MaximeM48/Projet-Arduino-/Documentation/Inspirations/Design global.jpg

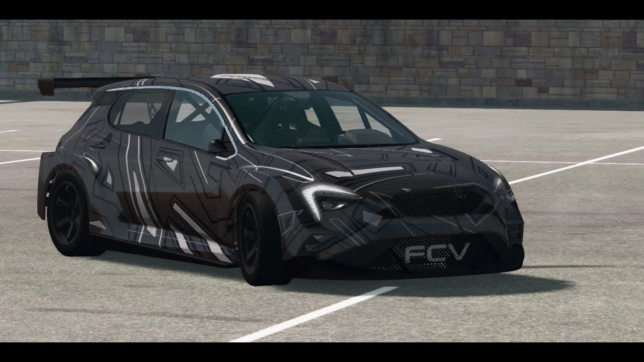
Documentation/Inspirations/Design global.jpg
