MaximeM48/Projet-Arduino-/README.md

# Projet Vivace
Voiture radiocommandée Arduino
# Présentation (Cahier des charges)
L'objectif du projet Vivace est de passer du jeu vidéo à la réalité en créant une voiture radiocommandée contrôlable à longue distance (par une manette de jeu) et dotée d'une caméra avant et arrière (et d'un radar de recul) afin d'avoir un retour vidéo.
De plus, la voiture sera dotée de quatres roues motrices, de suspensions réglables afin de modifier la garde au sol du véhicule et d'éléments esthétiques déplyables comme un aileron arrière, avant et des phares de rallye sur le capot. La voiture aura donc des modes de conduite pré-enregistés (route, circuit, rallye) qui pourront être séléctionnés par l'utilisateur ainsi que tous les feux fonctionnels.
L'objectif final de ce projet serait de développer une application ou une interface permettant d'avoir accès à toutes les informations de la voiture: feux activés, éléments esthétiques déployés, vitesse, retour caméra, mode de conduite sélectionné. De plus, touts ces éléments pourraient être actionés de manière indépendente par l'utilisateur, ce qui lui permettrait de créer ses propres "preset", qui seraient ensuite sauvegardés.
