MaximeM48/Projet-Arduino-/Rapports séances/KiliannCAVANIE/rapport 7.odt

Aujourd’hui on essaye de faire rouler la voiture. On assemble donc les éléments :

-récupération d’une plus petite plaque de connexion pour plus de place sur la voiture

-soudure des câbles au moteur et soudure de connecteurs pour les câbles des piles

-branchements des éléments (radar, moteurs, carte et bluetooth)

-mise en route du servomoteur pour la direction ( on ne savait pas que le bluetooth l’empêchait de fonctionner, on a donc mis le module bluetooth sur les ports série 0 et 1)

Après avoir tout branché, les moteurs tournent correctement, en revanche la voiture n’avance pas, on fait tourner les roues arrières uniquement, on espère qu’avec les quatre roues motrices cela sera suffisant pour la faire avancer.
