MaximeM48/Projet-Arduino-/Rapports séances/KiliannCAVANIE/Rapport Semaine 2.docx

05/01/2023

Récupération des modules HC12

Soudure des connecteurs et de l’antenne

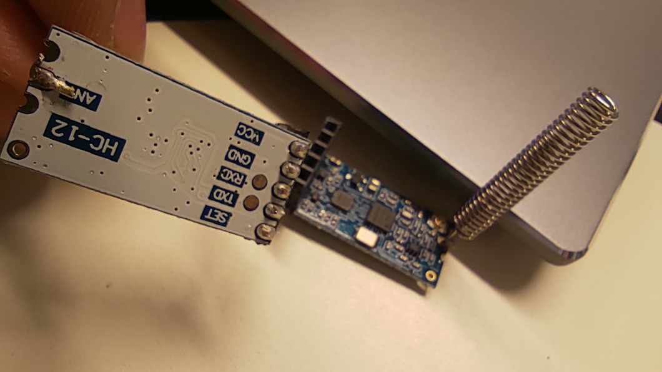
[picture p3: figure]

J’ai essayé d’allumer une led à distance en appuyant sur la manette Esplora.

D’abord, avec une arduino Uno connectée à un potentiomètre j’ai fait varier l’intensité de la led branchée à l’autre arduino.

Je n’y arrive pas avec la manette. Le problème semble venir de la connexion entre les HC12.

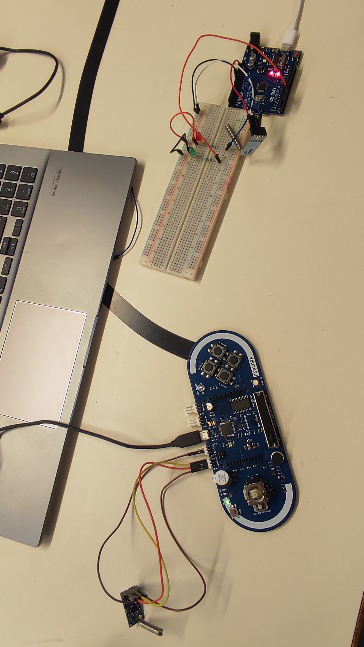
[picture p4: figure]
