MaximeM48/Projet-Arduino-/Rapports séances/KiliannCAVANIE/Rapport Semaine 1.odt

Cavanié Kiliann

Rapport Semaine 1

Recherche d’un moyen de communication avec la voiture :

-lien achat : https://fr.aliexpress.com/item/1005004751227369.html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

Bluetooth : je pensais la portée trop faible mais le module HC12 est plus performant

Communication RF : complexe car fonctionne sur la fréquence 433 déjà surutilisée

Caméra :

Choix d’une goPro, qui sera fixée sur la voiture et connectée en wifi avec un téléphone. Elle peut se brancher sur le module de batteries de la voiture ou si c’est trop compliqué, elle s’enlève et se recharge.

L’idée est de connecter une manette de console à l’arduino (grâce au module qui suit), de récupérer les infos des boutons, puis de transmettre ces infos au module de la voiture (exemples : gâchette ->accélérer, bouton a -> mode rally)

Explication module manette ps2 :https://create.arduino.cc/projecthub/electropeak/how-to-interface-ps2-wireless-controller-w-arduino-a0a813

mannette+module : https://www.fnac.com/mp33022153/Manette-sans-fil-pour-Sony-Playstation-2-PS2-PSTwo-2-4-Gz-Stra%C3%9Fe-Game/w-4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

module HC12 : https://fr.aliexpress.com/item/1005004751227369.html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

Pas de test possible, car pas de matériel.

But prochaine séance :

Allumer une led située sur une arduino uno connectée en bluetooth (avec HC12) à une autre arduino uno, avec la manette connectée à la deuxième arduino.

Commencer à réaliser le code final pour le passage de l’information de la manette au module manette.
