MaximeM48/Projet-Arduino-/Rapports séances/MaximeMOULERGUE/Liens Rapport de Séance n°7.md

Vidéo du sytème de fixation des suspensions: https://youtu.be/VaSTzW4_R-U

Vidéo du problème de friction du système de direction: https://youtu.be/FhrqxSMbe8c
