MaximeM48/Projet-Arduino-/Rapports séances/MaximeMOULERGUE/Liens Rapport de Séance n°6.md

Vidéo de la réduction du jeu de la direction: https://youtu.be/DLsT7-fFqx8

Vidéo du fonctionnement de la manette: https://youtu.be/V-dShEylgRc
