MaximeM48/Projet-Arduino-/Rapports séances/MaximeMOULERGUE/Liens Rapport de Séance n°5.md

Vidéo du fonctionnement du système de direction: https://youtu.be/tCHEKcswq-I

Vidéo du jeu dans le système de direction: https://youtu.be/m2mAMo9HPvs

Vidéo du jeu dans les roues: https://youtu.be/w4u5kTcNl7w
