MaximeM48/Projet-Arduino-/Rapports séances/KiliannCAVANIE/Rapport 6.docx

J’ai transformé mon code permettant d’écouter les informations de la manette en une fonction qui modifie un tableau composé de ces informations. Cela permet rend le code beaucoup plus lisible (loop clair).

Après recherches, il n’existe qu’un seul écran compatible avec la manette Esplora, et si on le commande cela couterait cher pour l’apport au projet, et il n’arriverait pas dans les délais.

La semaine prochaine on réfléchira à l’organisation des éléments sur la voiture, on a pour cela besoin de finir le système de suspension.
