MaximeM48/Projet-Arduino-/Rapports séances/KiliannCAVANIE/Rapport Semaine 4.odt

Je n’ai pas réussi à recevoir correctement les données du joystick.

J’ai essayé de récupérer un programme sur internet qui semblait faire exactement ce que je voulais, mais avec des modules Bluetooth et pas radio fréquence comme les HC12 du projet. J’ai compris le programme et ça m’a déjà appris pas mal de chose (notamment les différences entre un char et un String) et je me suis fait une idée globale du programme, mais ça ne marchait pas. J’ai donc essayé de le refaire moi-même, sans plus grand succès.

Je me suis rappelé que le module HC12 pouvait communiquer sur plusieurs canaux, je me suis dit que ce serait beaucoup plus simple d’envoyer les coordonnées x sur un canal et les y sur un autre (plus de problème de conversion avec des caractère en ascii ou non, etc) mais en réalité après quelque recherche c’est tout aussi compliqué : pour changer de canal il faut envoyer une certaine commande au module, et pour cela passer en mode commande, qui, si j’ai bien compris, se fait en mettant la masse au pin SET. Je n’ai pas complètement abandonné cette idée mais elle ne semble pas être la plus simple (je n’ai pas vu ce genre de programme sur intenet).

Je pense repartir à 0, et faire de petit programme en envoyant d’abord juste un caractère, puis juste une String…

Puis prochaine séance, choix des modes de conduites/ led (récupérer les info des boutons en plus du joystick) et écran manette (afficher le mode de conduite)
