MaximeM48/Projet-Arduino-/Rapports séances/KiliannCAVANIE/Rapport Semaine 3.docx

Le montage précédent fonctionne, les leds étaient juste mal branchées.

Aujourd’hui, le planning signifiait que je devais m’occuper du code qui va gérer les moteurs.

Objectif : récupérer et envoyer correctement les informations du joystick de la manette

On peut récupérer les informations X et Y du joystick. (Esplora.readJoystickX())

Je n’arrive pas à recevoir/ convertir les données correctement entre les modules de communication.

L’objectif est d’envoyer un couple de nombres, le module de la manette va envoyer un string « <123 ;456> » avec 123 et 456 les X et Y du joystick, qui doivent être récupérés correctement par le module de la voiture.

Je ne comprends pas encore bien quel type de donné est envoyé par le module HC12, il semble que lorsque j’envoie un String, il l’encode en ASCII, mais ne le décode pas à la réception.
