MaximeM48/Projet-Arduino-/Rapports séances/MaximeMOULERGUE/MOULERGUE-Rapport de séance n°2.pdf

MOULERGUE | Rapport de séance n°2

Maxime

1-Moteur

Nous avons décidé d’utiliser un unique moteur à double arbre afin d’éviter les différences de vitesse de rotation entre le train avant et arrière dues à l’utilisation de plusieurs moteurs qui ne fournissent jamais la même vitesse de rotation.

Nous allons donc utiliser un des moteurs jaunes que vous nous avez fourni, étant donné qu’il est doté d’un double arbre.

Pour le moteur actionnant le système de suspension, nous avons également un autre des moteurs que vous nous avez fourni. (Voir système dans la suite du compte-rendu).

Nous aurons également besoin de 5 servomoteurs afin de contrôler la direction et les différents éléments amovibles de la voiture.

2-Fonctionnement des suspensions

J’ai continué de perfectionner le système de suspension amovible en 3D afin d’être sûr que ce système fonctionne.

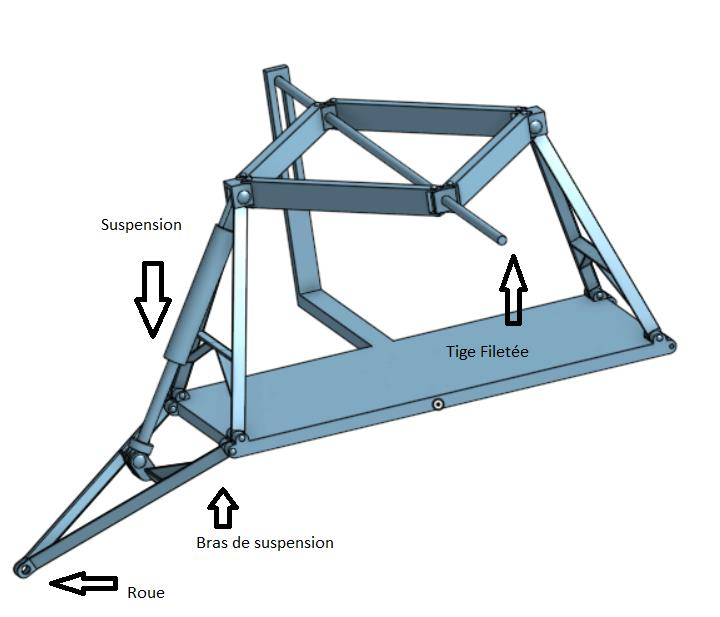
[picture p26: figure]

Vidéo de fonctionnement ici : https://youtu.be/oI-WJqhaRsM

3-Pièces à commander

Les pièces mécaniques étant des éléments difficiles à réaliser, j’ai donc dû chercher des pièces simples, pas chères et qui étaient compatibles entre elles. J’ai donc trouvé les 4 triangles de roues, les roues, les suspensions, les cardans, les fusées avant et arrière, les biellettes de direction, les tirants supérieurs de suspension et les différentiels. Les liens de toutes les pièces sont disponibles cidessous :

Tirants de suspension : https://www.breizh-modelisme.com/piece-ftx-carnage-5538-5537-charbon/21435349-tirant-superieur-de-suspension-arriere-x2-ftx-carnage-ftx6328.html (https://www.breizh-modelisme.com/piece-ftx-carnage-5538-5537-charbon/21435349-tirant-superieur-de-suspension-arriere-x2-ftx-carnage-ftx6328.html)

Fusées avant : https://www.efm-modelisme.fr/article/273206

Fusées arrière : https://www.breizh-modelisme.com/piece-ftx-carnage-5538-5537-charbon/18503003-2-portes-fusees-arriere-ftx-carnage-vantageftx6217.html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 (https://www.breizh-modelisme.com/piece-ftx-carnage-5538-5537-charbon/18503003-2-portes-fusees-arriere-ftx-carnage-vantage-ftx6217.html)

Triangles : https://www.breizh-modelisme.com/piece-ftx-carnage-5538-5537-charbon/19122485-2-bras-de-suspensions-inferieur-avant-ftx-carnage-ftx6320-118412.html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 (https://www.breizh-modelisme.com/piece-ftx-carnage-5538-5537-charbon/19122485-2-bras-de-suspensions-inferieur-avant-ftx-carnage-ftx6320-118412.html)

Suspensions : https://www.amazon.fr/INJORA-Amortisseur-Absorbers-Crawler-AXI231017/dp/B08GLYGFKD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 (https://www.amazon.fr/INJORA-Amortisseur-Absorbers-Crawler-AXI231017/dp/B08GLYGFKD?hvadid=488195846570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)

Biellettes de direction : https://www.breizh-modelisme.com/pieces-e-revo-20-traxxas/24320560-biellette-de-direction-3x50mm-x2-traxxas-trx5341.html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 wE (https://www.breizh-modelisme.com/pieces-e-revo-20-traxxas/24320560-biellette-de-direction-3x50mm-x2-traxxas-trx5341.html)

Différentiel : https://www.breizh-modelisme.com/piece-t2m-pirate-shooter-t4931/30019572-kittransmission-av-ar-t2m-t4905-6.html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 (https://www.breizh-modelisme.com/piece-t2m-pirate-shooter-t4931/30019572-kit-transmission-av-ar-t2m-t4905-6.html)

Roues :
https://fr.aliexpress.com/item/1005004970523750.html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 d%3A092900b0-d1bc-4afb-a959-fc8933af075b&afTraceInfo=1005004970523750__pc__pcBridgePPC__xxxxxx__1672496901&gatewa yAdapt=glo2fra (https://fr.aliexpress.com/item/1005004970523750.html?_t=pvid%3A092900b0-d1bc-4afb-a959-fc8933af075b)

Cardans :
https://fr.aliexpress.com/item/1005004384761056.html?pdp_npi=2%40dis%21EUR%21%E2%82%AC %205%2C58%213%2C35%20%E2%82%AC%21%21%21%21%21%40211b5e2516724979484637593e4 7a8%2112000028990696970%21btf&_t=pvid%3Abe5fe375-bab9-413c-ad20-b8d88580a3a5&afTraceInfo=1005004384761056__pc__pcBridgePPC__xxxxxx__1672497948&spm=a 2g0o.ppclist.product.mainProduct&gatewayAdapt=glo2fra (https://fr.aliexpress.com/item/1005004384761056.html?_t=pvid%3Abe5fe375-bab9-413c-ad20-b8d88580a3a5)
