MaximeM48/Projet-Arduino-/Documentation/Diagramme de Gantt.PNG

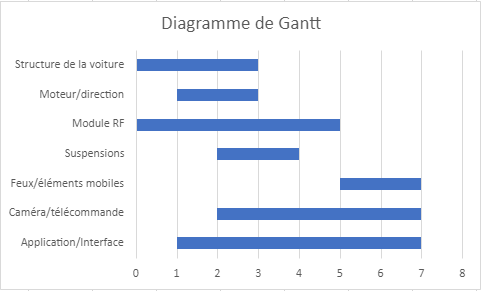
Documentation/Diagramme de Gantt.PNG
