MaximeM48/Projet-Arduino-/Documentation/Planning Projet Arduino.PNG

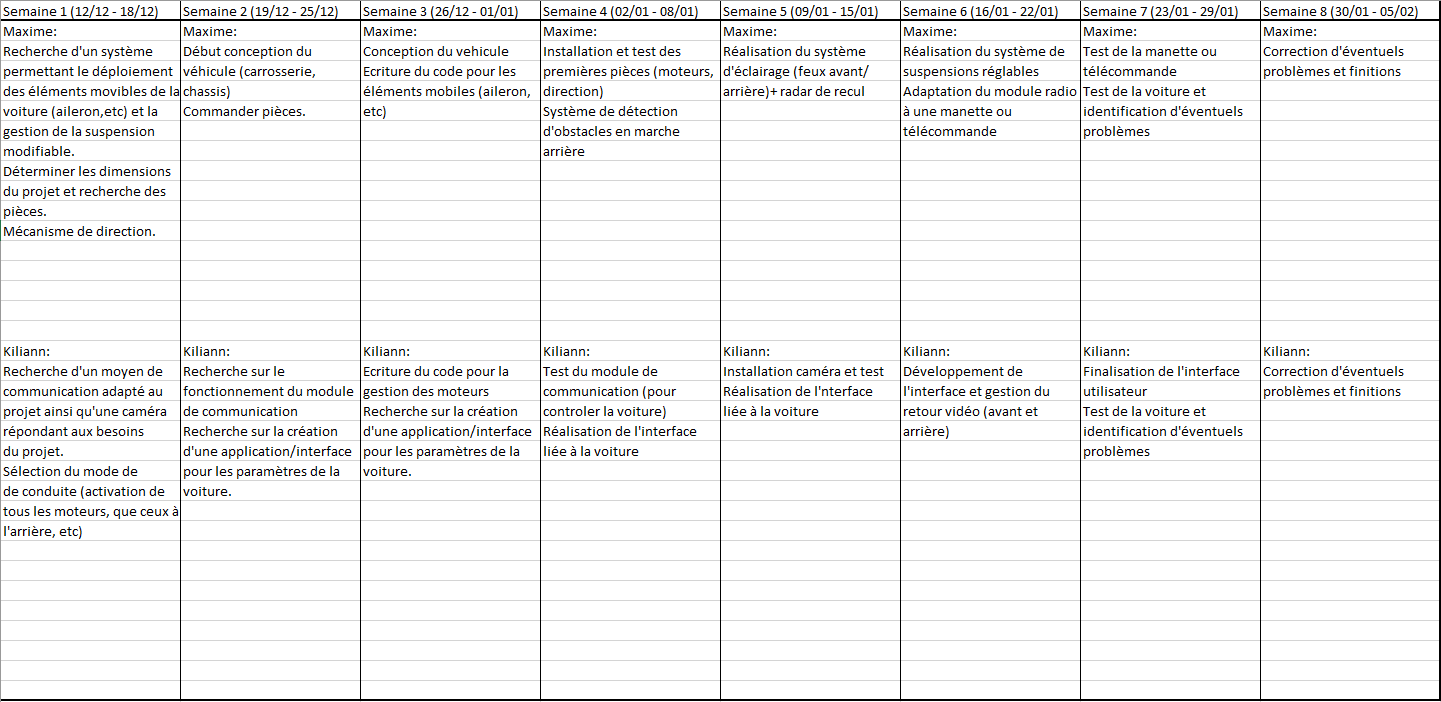
Documentation/Planning Projet Arduino.PNG
