MaximeM48/Projet-Arduino-/Présentation/Projet ViVace.pdf

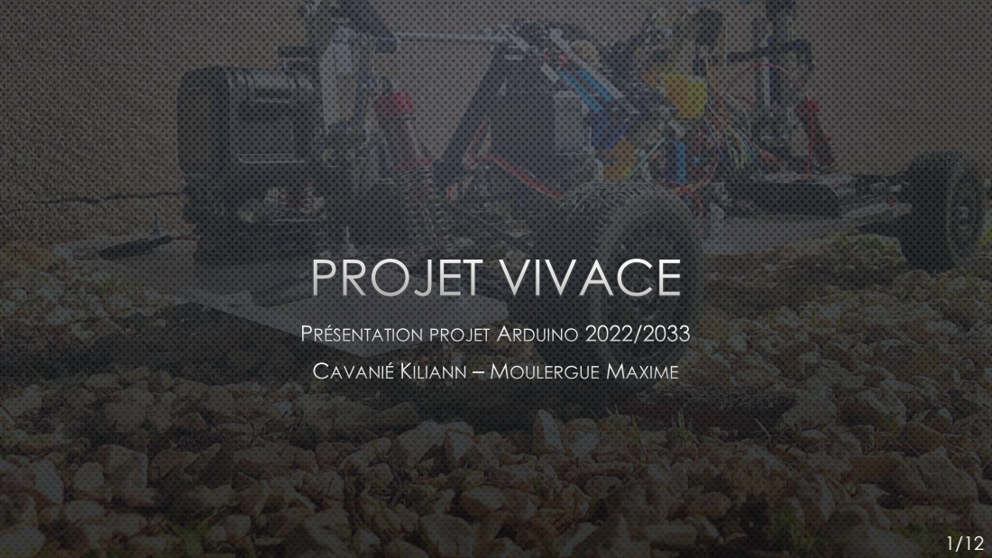
[picture p29: page 1]

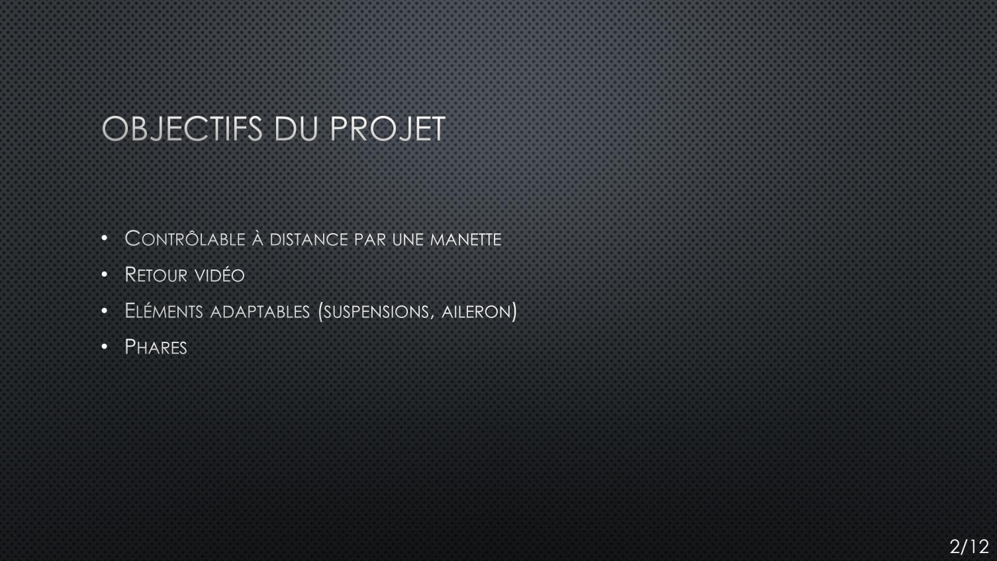
[picture p30: page 2]

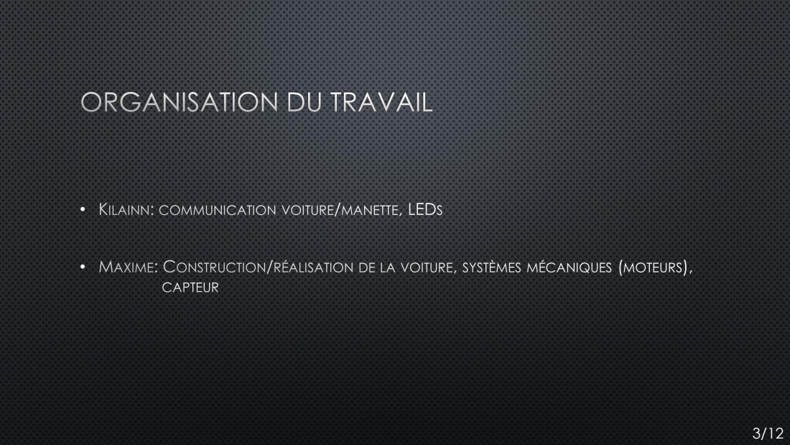
[picture p31: page 3]

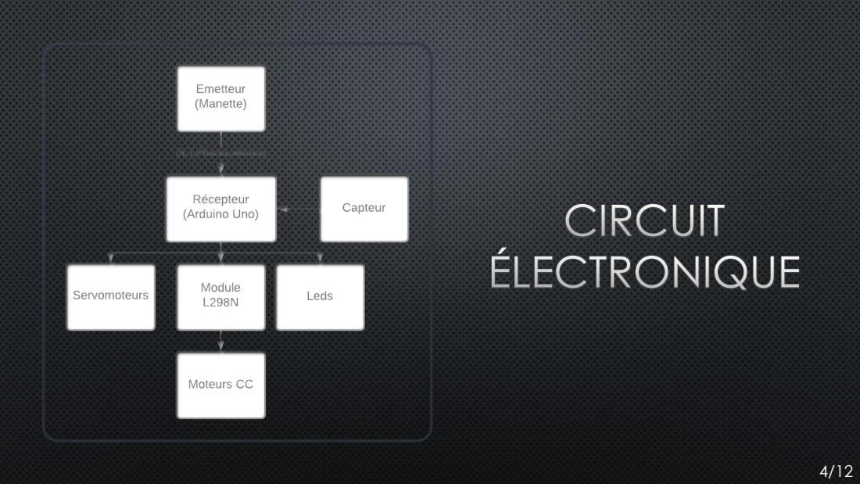
[picture p32: page 4]

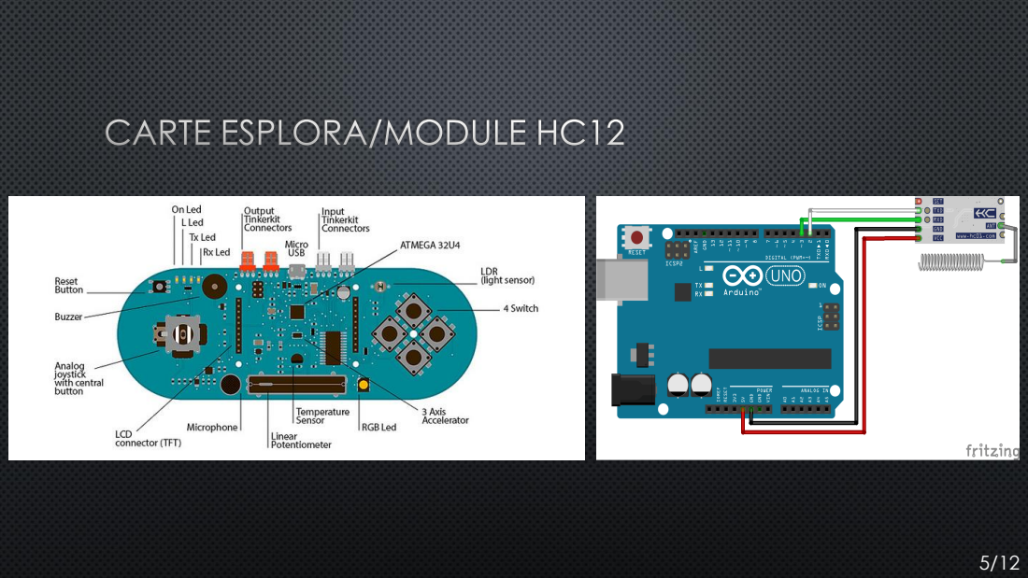
[picture p33: page 5]

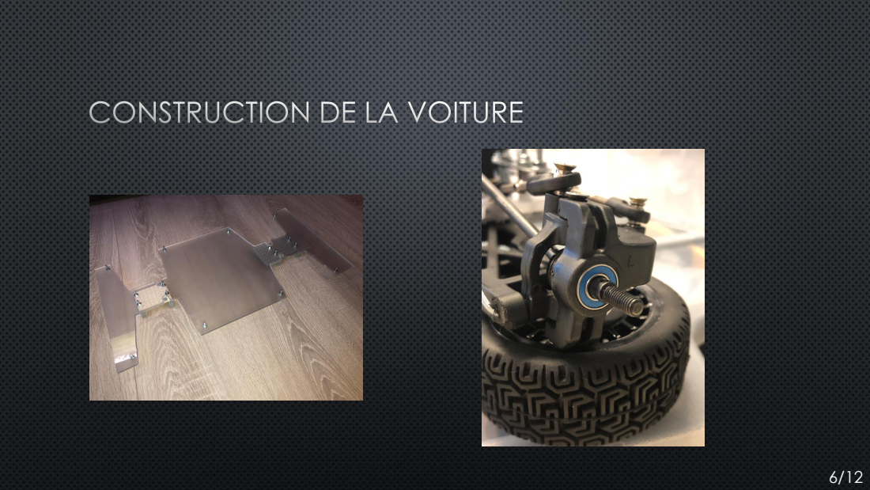
[picture p34: page 6]

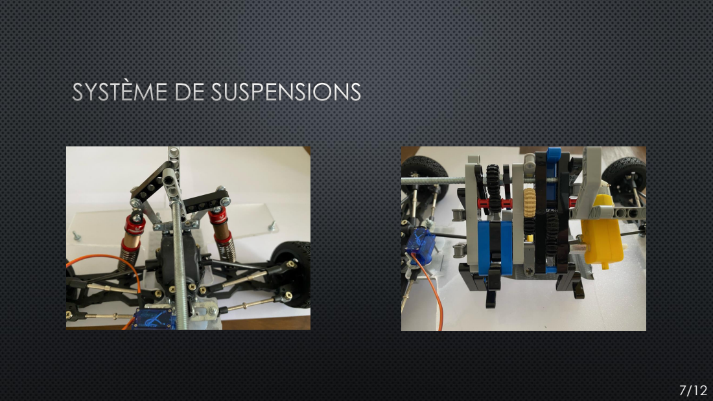
[picture p35: page 7]

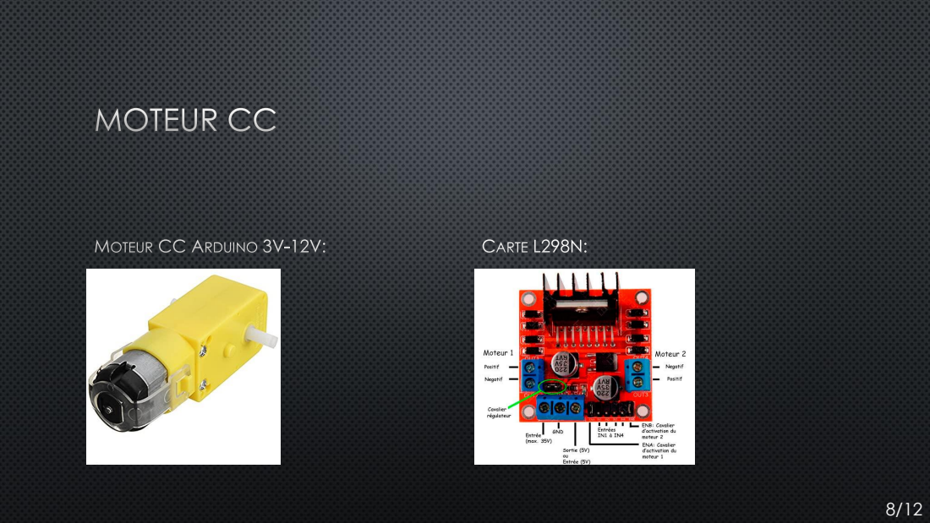
[picture p36: page 8]

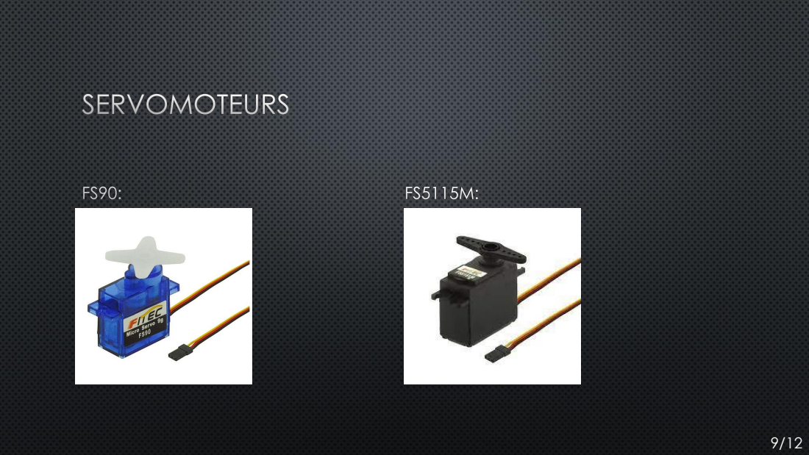
[picture p37: page 9]

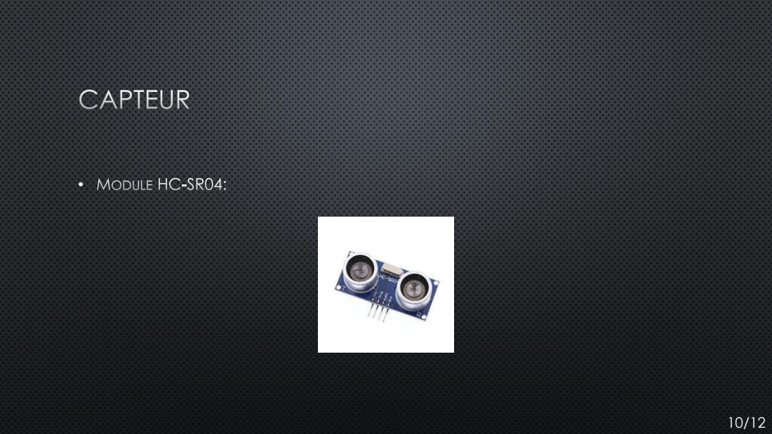
[picture p38: page 10]

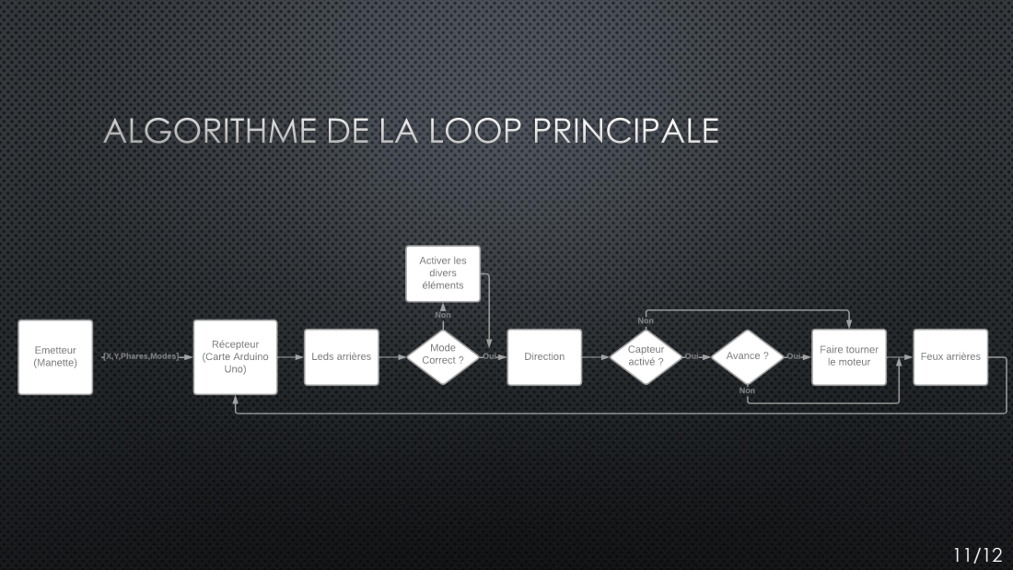
[picture p39: page 11]

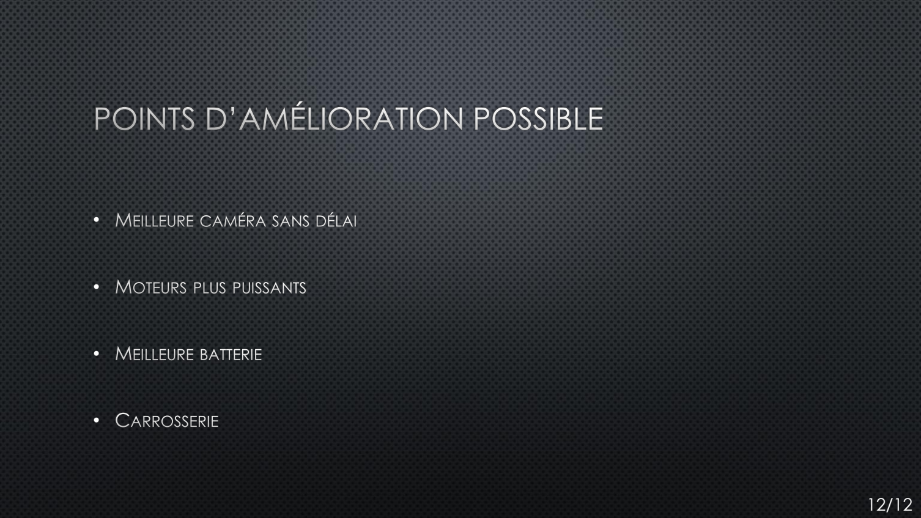
[picture p40: page 12]
