MaximeM48/Projet-Arduino-/(commit log)

2023-01-05 Create Liens Rapport de Séance n°2.md
2023-01-05 Update Liens Rapport de Séance n°2.md
2023-01-30 Create Liens Rapport de Séance n°5.md
2023-01-30 Update Liens Rapport de Séance n°5.md
2023-02-06 Create Liens Rapport de Séance n°6.md
2023-02-13 Create Liens Rapport de Séance n°7.md
